ESEpasseronji/project/Component/charge_controller/21-0113D_MXM.step

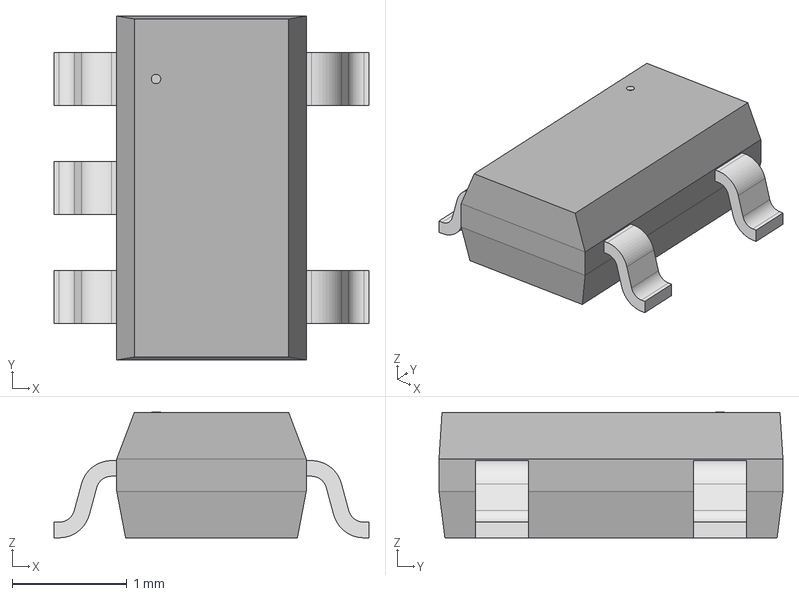
[picture p17: CAD file, 2020-12-09]
Component/charge_controller/21-0113D_MXM.step
2.74 x 3.00 x 1.09 mm
