ESEpasseronji/project/Component/voltage_regulator/21-0061L_MXM.step

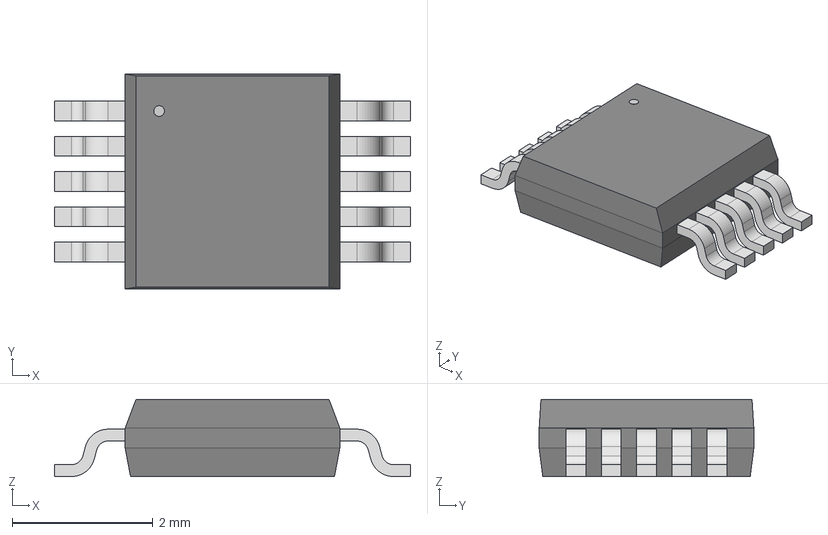
[picture p18: CAD file, 2020-12-09]
Component/voltage_regulator/21-0061L_MXM.step
5.05 x 3.05 x 1.09 mm
