ESEpasseronji/project/(list of files, cad)

Other CAD files:
Component/battery_connector/jst_b2b-ph-k-slfsn.psm
Component/battery_led/red_led.psm
Component/charge_controller/21-0113d_mxm.psm
Component/switch/sw_js102011saqn.psm
Component/usb_connector/fci_10118193-0001lf.psm
Component/usb_led/green_led.psm
Component/voltage_regulator/21-0061l_mxm.psm
