ESEpasseronji/project/(list of files, drawings)

Other design files:
Component/battery_connector/B2B-PH-K-SLFSN.OLB
Component/battery_connector/b2b-ph-k-slfsn.opj
Component/charge_controller/2020-12-07_20-36-55.OLB
Component/charge_controller/2020-12-07_20-36-55.opj
Component/switch/JS102011SAQN.OLB
Component/switch/js102011saqn.opj
Component/usb_connector/10118193-0001LF.OLB
Component/usb_connector/10118193-0001lf.opj
Schematic_Power_management/CO_LIBRARY.OLB
Schematic_Power_management/co_library.opj
Schematic_Power_management/CO_SENSOR.DSN
Schematic_Power_management/CO_sensor.opj
Schematics/CO_sensor/CO_SENSOR.DSN
Schematics/CO_sensor/CO_sensor.opj
