ESEpasseronji/project/(commit log)

2020-12-09 Added micro datasheet, padstack and footprint
2020-12-10 last commit
    [10118193-0001LF.OLB, 10118193-0001lf.opj, 2020-12-07_20-36-55.OLB, 2020-12-07_20-36-55.opj, B2B-PH-K-SLFSN.OLB, JS102011SAQN.OLB]
2020-12-11 modifications to the files
    [CO_sensor.opj, b2b-ph-k-slfsn.opj, co_library.opj, js102011saqn.opj]
2021-01-16 Added mounting holes
2021-01-18 Manual footprint
2021-01-19 Version 5 of the sensor added
